RoboJackets/urc-electrical/boards/arm_board_v2.0/README.txt

Imported Library List: 

Teensy symbol and footprints library: 

symbol link:   https://github.com/XenGi/teensy_library

footprints link:   https://github.com/XenGi/teensy.pretty

TMC2209 library: 
symbol and footprints link:   https://www.snapeda.com/parts/TMC2209%20SILENTSTEPSTICK/Trinamic%20Motion%20Control%20GmbH/view-part/

J00-0045NL library: 
symbol and footprints link:   https://www.snapeda.com/parts/J00-0045NL/Pulse%20Electronics%20Network/view-part/
