RoboJackets/urc-electrical/logo/RoboBuzz wireframe.dxf

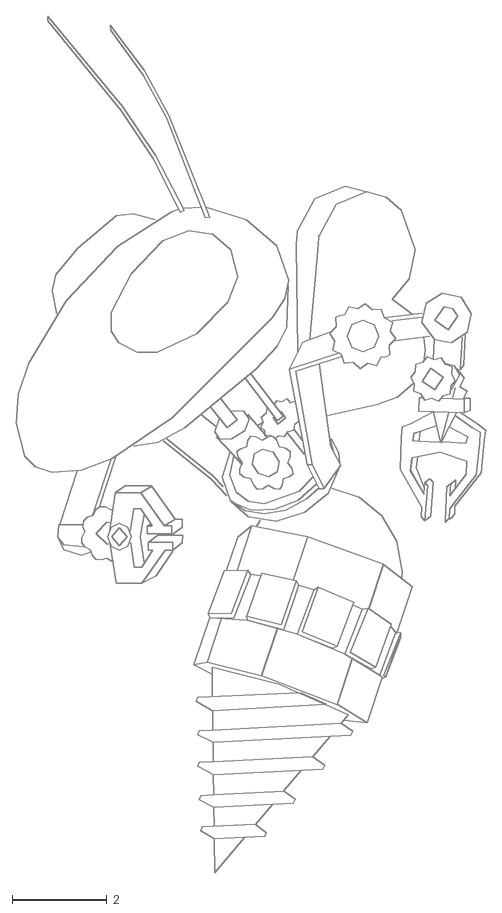
[picture p1: CAD file, 2024-04-24]
logo/RoboBuzz wireframe.dxf
9.93 x 18.1
