RoboJackets/urc-electrical/(list of files, drawings)

Other design files:
boards/arm_board_v2.0/Imported arm/arm.PcbDoc
boards/arm_board_v2.0/Imported arm/arm.PrjPcb
boards/arm_board_v2.0/Imported arm/arm.SchDoc
boards/arm_board_v2.0/Imported arm/arm.SchLib
