RoboJackets/urc-electrical/boards/Science_Board_v2.0/science-board-new.kicad_pcb

## KiCad design boards/Science_Board_v2.0/science-board-new.kicad_pcb (2025-05-12)

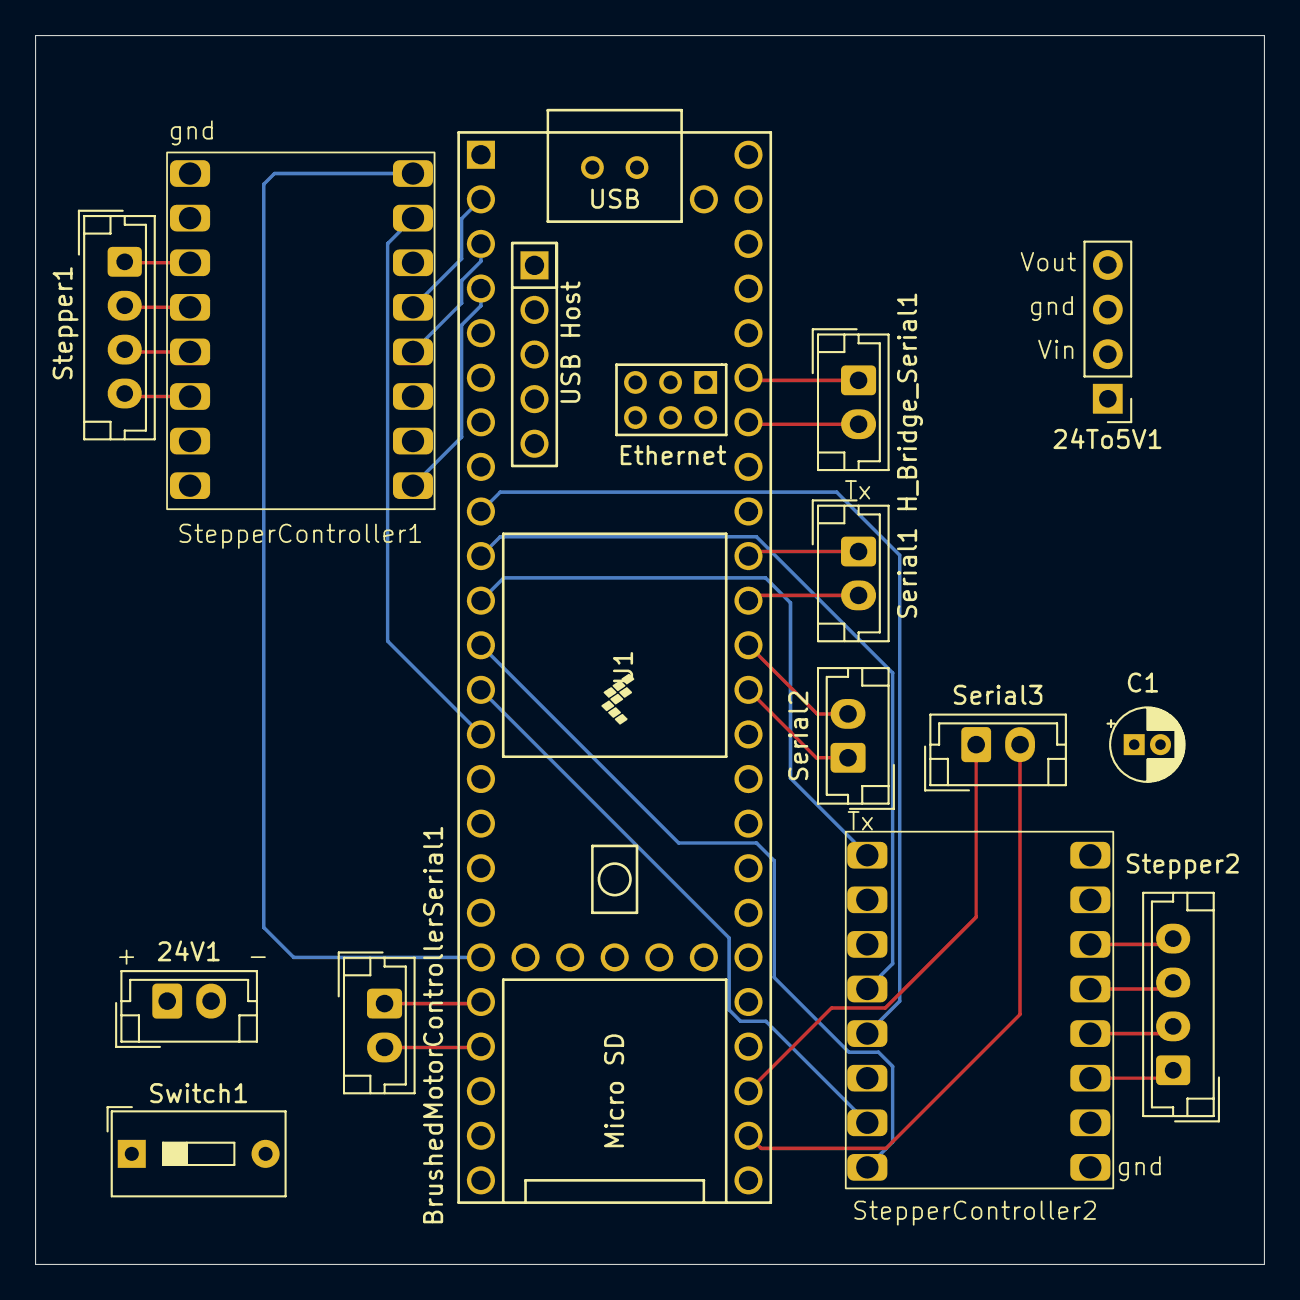
[picture p2: board science-board-new.kicad_pcb from above]

Board: 4 copper layers, 70.0 x 70.0 mm, 14 parts (0 on the bottom side), 34 nets.

Parts:
24To5V1: PinHeader_1x04_P2.54mm_Vertical
24V1: Conn_01x02; JST_EH_B2B-EH-A_1x02_P2.50mm_Vertical
BrushedMotorControllerSerial1: Conn_01x02; JST_EH_B2B-EH-A_1x02_P2.50mm_Vertical
C1: C; CP_Radial_D4.0mm_P1.50mm
H_Bridge_Serial1: Conn_01x02; JST_EH_B2B-EH-A_1x02_P2.50mm_Vertical
Serial1, Serial2, Serial3: Conn_01x02; JST_EH_B2B-EH-A_1x02_P2.50mm_Vertical
Stepper1, Stepper2: Conn_01x04; JST_EH_B4B-EH-A_1x04_P2.50mm_Vertical
StepperController1, StepperController2: Bigtree_Tech_TMC2209_V1.3
Switch1: SW_DIP_x01; SW_DIP_SPSTx01_Slide_9.78x4.72mm_W7.62mm_P2.54mm
U1: Teensy4.1; Teensy41

Connections:
/3v3_Stepper_Motor_1: StepperController1.15 (VIO), U1.46 (3V3)
/3v3_Stepper_Motor_2: StepperController2.15 (VIO), U1.15 (3V3)
/DIR_Stepper_Motor_1: StepperController1.8 (DIR), U1.19 (27_A13_SCK1)
/DIR_Stepper_Motor_2: StepperController2.8 (DIR), U1.12 (10_CS_MQSR)
/GND_Teensy: 24To5V1.3 (GND), 24V1.2, C1.2, StepperController1.10 (GND), StepperController1.16 (GND), StepperController2.10 (GND), StepperController2.16 (GND), U1.1 (GND), U1.34 (GND), U1.47 (GND)
/OUT_1: StepperController2.1 (EN), U1.11 (9_OUT1C)
/OUT_2: StepperController1.1 (EN), U1.4 (2_OUT2)
/RX_5_H_Bridge: H_Bridge_Serial1.1, U1.43 (21_A7_RX5_BCLK1)
/RX_Serial_1: Serial1.2, U1.38 (16_A2_RX4_SCL1)
/RX_Serial_2: Serial2.2, U1.37 (15_A1_RX3_SPDIF_IN)
/RX_Serial_3: Serial3.2, U1.26 (34_RX8)
/RX_Stepper_Motor_1: StepperController1.5 (TX), U1.2 (0_RX1_CRX2_CS1)
/RX_Stepper_Motor_2: StepperController2.5 (TX), U1.9 (7_RX2_OUT1A)
/RX_drill: BrushedMotorControllerSerial1.1, U1.20 (28_RX7)
/STEP_Stepper_Motor_1: StepperController1.7 (STEP), U1.14 (12_MISO_MQSL)
/STEP_Stepper_Motor_2: StepperController2.7 (STEP), U1.13 (11_MOSI_CTX1)
/TX_5_H_Bridge: H_Bridge_Serial1.2, U1.42 (20_A6_TX5_LRCLK1)
/TX_Serial_1: Serial1.1, U1.39 (17_A3_TX4_SDA1)
/TX_Serial_2: Serial2.1, U1.36 (14_A0_TX3_SPDIF_OUT)
/TX_Serial_3: Serial3.1, U1.27 (35_TX8)
/TX_Stepper_Motor_1: StepperController1.4 (RX), U1.3 (1_TX1_CTX2_MISO1)
/TX_Stepper_Motor_2: StepperController2.4 (RX), U1.10 (8_TX2_IN1)
/TX_drill: BrushedMotorControllerSerial1.2, U1.21 (29_TX7)
unnamed: 24To5V1.2 (Vin), C1.1, StepperController1.9 (VS), StepperController2.9 (VS), Switch1.2
unnamed: 24To5V1.4 (Vout), U1.48 (VIN)
unnamed: 24V1.1, Switch1.1
unnamed: Stepper1.1, StepperController1.14 (B2)
unnamed: Stepper1.2, StepperController1.13 (B1)
unnamed: Stepper1.3, StepperController1.12 (A1)
unnamed: Stepper1.4, StepperController1.11 (A2)
unnamed: Stepper2.1, StepperController2.14 (B2)
unnamed: Stepper2.2, StepperController2.13 (B1)
unnamed: Stepper2.3, StepperController2.12 (A1)
unnamed: Stepper2.4, StepperController2.11 (A2)
