RoboJackets/urc-electrical/boards/arm_board_v2.0/arm.kicad_pcb

## KiCad design boards/arm_board_v2.0/arm.kicad_pcb (2025-05-12)

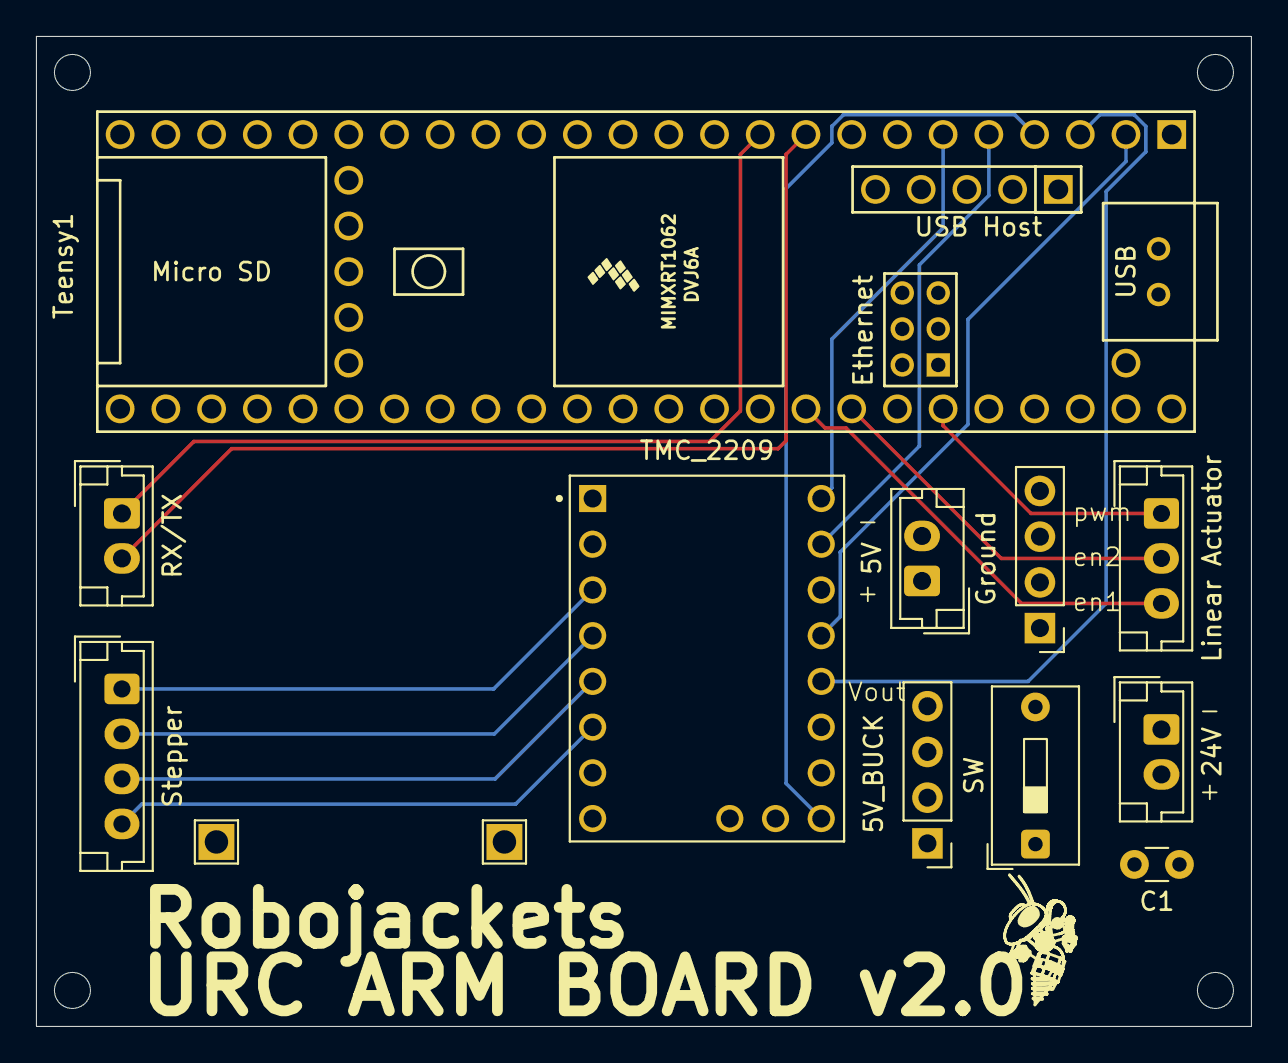
[picture p3: board boards/arm_board_v2.0/arm.kicad_pcb from above]

Board: 4 copper layers, 67.5 x 55.0 mm, 11 parts (0 on the bottom side), 19 nets.

Parts:
5V: GROUND; JST_EH_B2B-EH-A_1x02_P2.50mm_Vertical
5V_BUCK: PololuD24V5F5; PinHeader_1x04_P2.54mm_Vertical
24V: 24V; JST_EH_B2B-EH-A_1x02_P2.50mm_Vertical
C1: 33 nF; C_Disc_D3.0mm_W1.6mm_P2.50mm
Ground: Output; PinHeader_1x04_P2.54mm_Vertical
Linear Actuator: Actuator; JST_EH_B3B-EH-A_1x03_P2.50mm_Vertical
RX/TX: TX; JST_EH_B2B-EH-A_1x02_P2.50mm_Vertical
SW: SW_DIP_x01; SW_DIP_SPSTx01_Slide_9.78x4.72mm_W7.62mm_P2.54mm
Stepper: Output; JST_EH_B4B-EH-A_1x04_P2.50mm_Vertical
TMC_2209: TMC2209_SILENTSTEPSTICK; MODULE_TMC2209_SILENTSTEPSTICK
Teensy1: Teensy4.1; Teensy41

Connections:
/24V: 5V_BUCK.2 (Vin), C1.1, SW.1, TMC_2209.8 (VM)
/A1: Stepper.1, TMC_2209.3 (MA1)
/A2: Stepper.2, TMC_2209.4 (MA2)
/B1: Stepper.3, TMC_2209.5 (MB1)
/B2: Stepper.4, TMC_2209.6 (MB2)
/Switch: 24V.2, SW.2
/VIO: TMC_2209.2 (VIO), Teensy1.46 (3V3)
/Vin: 5V.1, 5V_BUCK.4 (Vout), Teensy1.48 (VIN)
GND: 5V.2, 5V_BUCK.3 (GND), 24V.1, C1.2, Ground.1, Ground.2, Ground.3, Ground.4, TMC_2209.1 (GND), TMC_2209.7 (GND), Teensy1.47 (GND)
unnamed: Linear Actuator.1, Teensy1.43 (21_A7_RX5_BCLK1)
unnamed: Linear Actuator.2, Teensy1.41 (19_A5_SCL)
unnamed: Linear Actuator.3, Teensy1.40 (18_A4_SDA)
unnamed: RX/TX.1, Teensy1.10 (8_TX2_IN1)
unnamed: RX/TX.2, Teensy1.9 (7_RX2_OUT1A)
unnamed: TMC_2209.9 (DIR), Teensy1.6 (4_BCLK2)
unnamed: TMC_2209.13 (RX), Teensy1.3 (1_TX1_CTX2_MISO1)
unnamed: TMC_2209.10 (STEP), Teensy1.5 (3_LRCLK2)
unnamed: TMC_2209.12 (TX), Teensy1.2 (0_RX1_CRX2_CS1)
unnamed: TMC_2209.16 (~EN), Teensy1.4 (2_OUT2)
