RoboJackets/urc-electrical/boards/arm_box_board/arm.kicad_pcb

## KiCad design boards/arm_box_board/arm.kicad_pcb (2025-04-29, an earlier design)

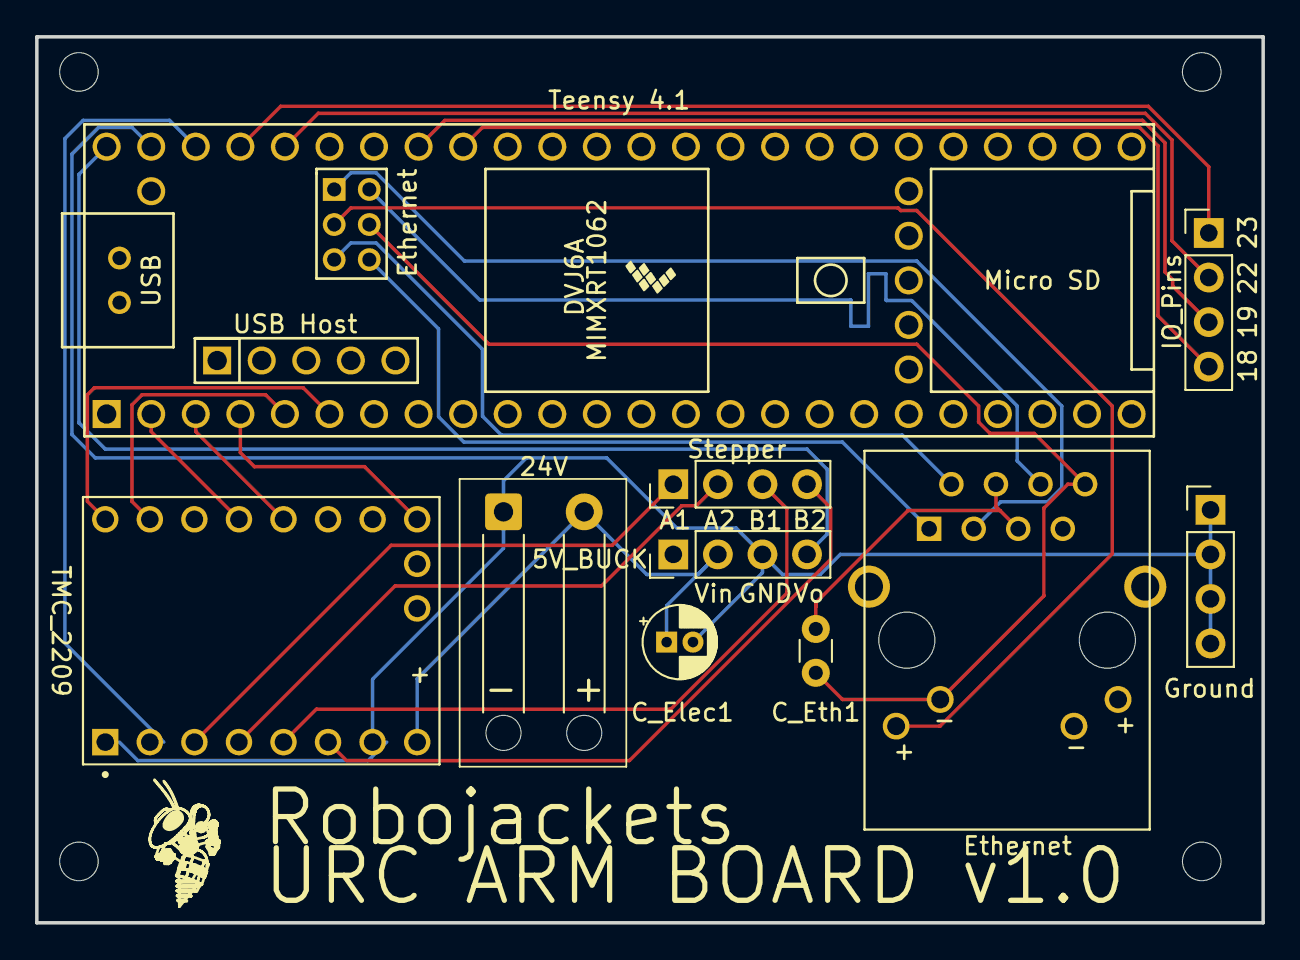
[picture p4: board boards/arm_box_board/arm.kicad_pcb from above]

Board: 2 copper layers, 69.9 x 50.5 mm, 10 parts (0 on the bottom side), 24 nets.

Parts:
5V_BUCK: PololuD24V5F5; PinHeader_1x04_P2.54mm_Vertical
24V: 24V; SolderWire-0.5sqmm_1x02_P4.6mm_D0.9mm_OD2.1mm_Relief
C_Elec1: C_Large; CP_Radial_D4.0mm_P1.50mm
C_Eth1: C_Small; C_Disc_D3.0mm_W1.6mm_P2.50mm
Ethernet: J00-0045NL; PULSE_J00-0045NL
Ground: Output; PinHeader_1x04_P2.54mm_Vertical
IO_Pins: Output; PinHeader_1x04_P2.54mm_Vertical
Stepper: Output; PinHeader_1x04_P2.54mm_Vertical
TMC_2209: TMC2209_SILENTSTEPSTICK; MODULE_TMC2209_SILENTSTEPSTICK
Teensy 4.1: Teensy4.1; Teensy41

Connections:
/A1: Stepper.1, TMC_2209.3 (MA1)
/A2: Stepper.2, TMC_2209.4 (MA2)
/B1: Stepper.3, TMC_2209.5 (MB1)
/B2: Stepper.4, TMC_2209.6 (MB2)
unnamed: 5V_BUCK.3 (GND), 24V.1, C_Elec1.2, Ground.1, Ground.2, Ground.3, Ground.4, TMC_2209.1 (GND), TMC_2209.7 (GND), Teensy 4.1.47 (GND)
unnamed: 5V_BUCK.2 (Vin), 24V.2, C_Elec1.1, TMC_2209.8 (VM)
unnamed: C_Eth1.1, Ethernet.4 (CTT), Ethernet.5 (CTR)
unnamed: C_Eth1.2, Ethernet.8 (GND), Ethernet.10 (LC), Teensy 4.1.64 (GND)
unnamed: Ethernet.9 (LA), Teensy 4.1.61 (LED)
unnamed: Ethernet.3 (RD+), Teensy 4.1.60 (R+)
unnamed: Ethernet.6 (RD-), Teensy 4.1.65 (R-)
unnamed: Ethernet.1 (TD+), Teensy 4.1.63 (T+)
unnamed: Ethernet.2 (TD-), Teensy 4.1.62 (T-)
unnamed: IO_Pins.1, Teensy 4.1.45 (23_A9_CRX1_MCLK1)
unnamed: IO_Pins.2, Teensy 4.1.44 (22_A8_CTX1)
unnamed: IO_Pins.3, Teensy 4.1.41 (19_A5_SCL)
unnamed: IO_Pins.4, Teensy 4.1.40 (18_A4_SDA)
unnamed: 5V_BUCK.4 (Vout), Teensy 4.1.48 (VIN)
unnamed: TMC_2209.9 (DIR), Teensy 4.1.6 (4_BCLK2)
unnamed: TMC_2209.13 (RX), Teensy 4.1.3 (1_TX1_CTX2_MISO1)
unnamed: TMC_2209.10 (STEP), Teensy 4.1.5 (3_LRCLK2)
unnamed: TMC_2209.12 (TX), Teensy 4.1.2 (0_RX1_CRX2_CS1)
unnamed: TMC_2209.2 (VIO), Teensy 4.1.46 (3V3)
unnamed: TMC_2209.16 (~EN), Teensy 4.1.4 (2_OUT2)
