RoboJackets/urc-electrical/boards/Main/Main/Main.kicad_pcb

## KiCad design boards/Main/Main/Main.kicad_pcb (2025-03-07)

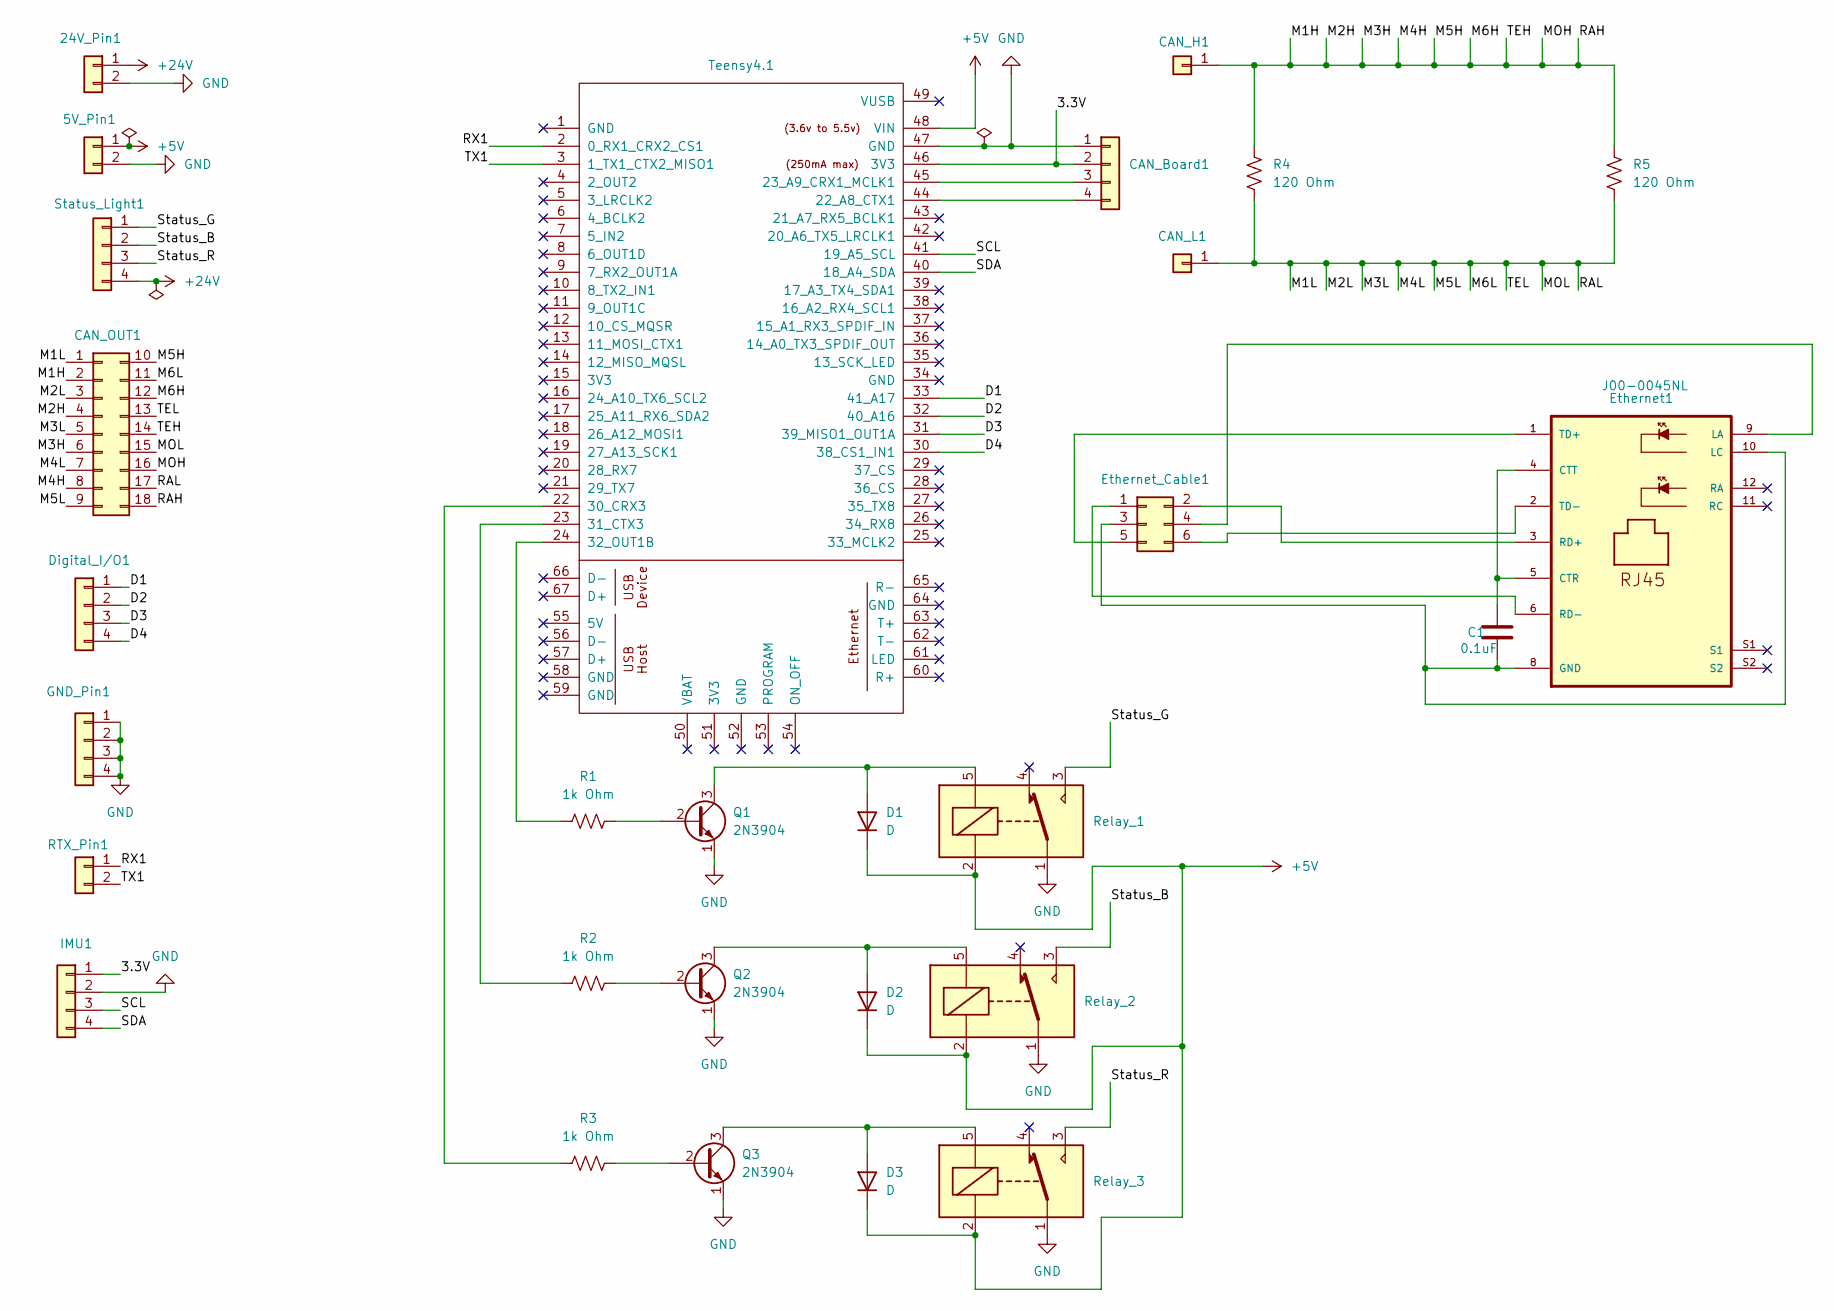
[picture p5: schematic Main.kicad_sch, Electrical Main Board]

Parts:
5V_Pin1: 5V; PinHeader_1x02_P2.54mm_Vertical
24V_Pin1: 24V; PinHeader_1x02_P2.54mm_Vertical
C1: 0.1uF; CP_Axial_L10.0mm_D4.5mm_P15.00mm_Horizontal
CAN_Board1: CAN_Board; PinHeader_1x04_P2.54mm_Vertical
CAN_H1: CAN_H; PinHeader_1x01_P2.54mm_Vertical
CAN_L1: CAN_L; PinHeader_1x01_P2.54mm_Vertical
CAN_OUT1: CAN_pins; PinHeader_2x09_P2.54mm_Vertical
D1, D2, D3: D; LED_D5.0mm
Digital_I/O1: Digital I/O; PinHeader_1x04_P2.54mm_Vertical
Ethernet1: J00-0045NL; PULSE_J00-0045NL
Ethernet_Cable1: Conn_02x03_Odd_Even; PinHeader_2x03_P2.54mm_Vertical
GND_Pin1: GND; PinHeader_1x04_P2.54mm_Vertical
IMU1: GND; PinHeader_1x04_P2.54mm_Vertical
Q1, Q2, Q3: 2N3904; TO-92_Inline
R1, R2, R3: 1k Ohm; R_Axial_DIN0309_L9.0mm_D3.2mm_P15.24mm_Horizontal
R4, R5: 120 Ohm; R_Axial_DIN0309_L9.0mm_D3.2mm_P15.24mm_Horizontal
RTX_Pin1: TX/RX; PinHeader_1x02_P2.54mm_Vertical
Relay_1: G5LE1_Green; Relay_SPDT_Omron-G5LE-1
Relay_2: G5LE1_Blue; Relay_SPDT_Omron-G5LE-1
Relay_3: G5LE1_Red; Relay_SPDT_Omron-G5LE-1
Status_Light1: Status_Light; PinHeader_1x04_P2.54mm_Vertical
Teensy4.1: Teensy4.1; Teensy41

Connections:
+5V: 5V_Pin1.1, D1.1 (K), D2.1 (K), D3.1 (K), Relay_1.2, Relay_2.2, Relay_3.2, Teensy4.1.48 (VIN)
+24V: 24V_Pin1.1, Status_Light1.4
/3.3V: CAN_Board1.2, IMU1.1, Teensy4.1.46 (3V3)
/D1: Digital_I/O1.1, Teensy4.1.33 (41_A17)
/D2: Digital_I/O1.2, Teensy4.1.32 (40_A16)
/D3: Digital_I/O1.3, Teensy4.1.31 (39_MISO1_OUT1A)
/D4: Digital_I/O1.4, Teensy4.1.30 (38_CS1_IN1)
/M1H: CAN_H1.1, CAN_OUT1.2, CAN_OUT1.4, CAN_OUT1.6, CAN_OUT1.8, CAN_OUT1.10, CAN_OUT1.12, CAN_OUT1.14, CAN_OUT1.16, CAN_OUT1.18, R4.1, R5.2
/M1L: CAN_L1.1, CAN_OUT1.1, CAN_OUT1.3, CAN_OUT1.5, CAN_OUT1.7, CAN_OUT1.9, CAN_OUT1.11, CAN_OUT1.13, CAN_OUT1.15, CAN_OUT1.17, R4.2, R5.1
/RX1: RTX_Pin1.1, Teensy4.1.2 (0_RX1_CRX2_CS1)
/SCL: IMU1.3, Teensy4.1.41 (19_A5_SCL)
/SDA: IMU1.4, Teensy4.1.40 (18_A4_SDA)
/Status_B: Relay_2.3, Status_Light1.2
/Status_G: Relay_1.3, Status_Light1.1
/Status_R: Relay_3.3, Status_Light1.3
/TX1: RTX_Pin1.2, Teensy4.1.3 (1_TX1_CTX2_MISO1)
GND: 5V_Pin1.2, 24V_Pin1.2, CAN_Board1.1, GND_Pin1.1, GND_Pin1.2, GND_Pin1.3, GND_Pin1.4, IMU1.2, Q1.1 (E), Q2.1 (E), Q3.1 (E), Relay_1.1, Relay_2.1, Relay_3.1, Teensy4.1.47 (GND)
unnamed: CAN_Board1.3, Teensy4.1.45 (23_A9_CRX1_MCLK1)
unnamed: CAN_Board1.4, Teensy4.1.44 (22_A8_CTX1)
unnamed: D1.2 (A), Q1.3 (C), Relay_1.5
unnamed: D2.2 (A), Q2.3 (C), Relay_2.5
unnamed: D3.2 (A), Q3.3 (C), Relay_3.5
unnamed: C1.1, Ethernet1.4 (CTT), Ethernet1.5 (CTR)
unnamed: C1.2, Ethernet1.8 (GND), Ethernet1.10 (LC), Ethernet_Cable1.3
unnamed: Ethernet1.9 (LA), Ethernet_Cable1.4
unnamed: Ethernet1.3 (RD+), Ethernet_Cable1.2
unnamed: Ethernet1.6 (RD-), Ethernet_Cable1.1
unnamed: Ethernet1.1 (TD+), Ethernet_Cable1.5
unnamed: Ethernet1.2 (TD-), Ethernet_Cable1.6
unnamed: Q1.2 (B), R1.2
unnamed: Q2.2 (B), R2.2
unnamed: Q3.2 (B), R3.2
unnamed: R3.1, Teensy4.1.22 (30_CRX3)
unnamed: R2.1, Teensy4.1.23 (31_CTX3)
unnamed: R1.1, Teensy4.1.24 (32_OUT1B)

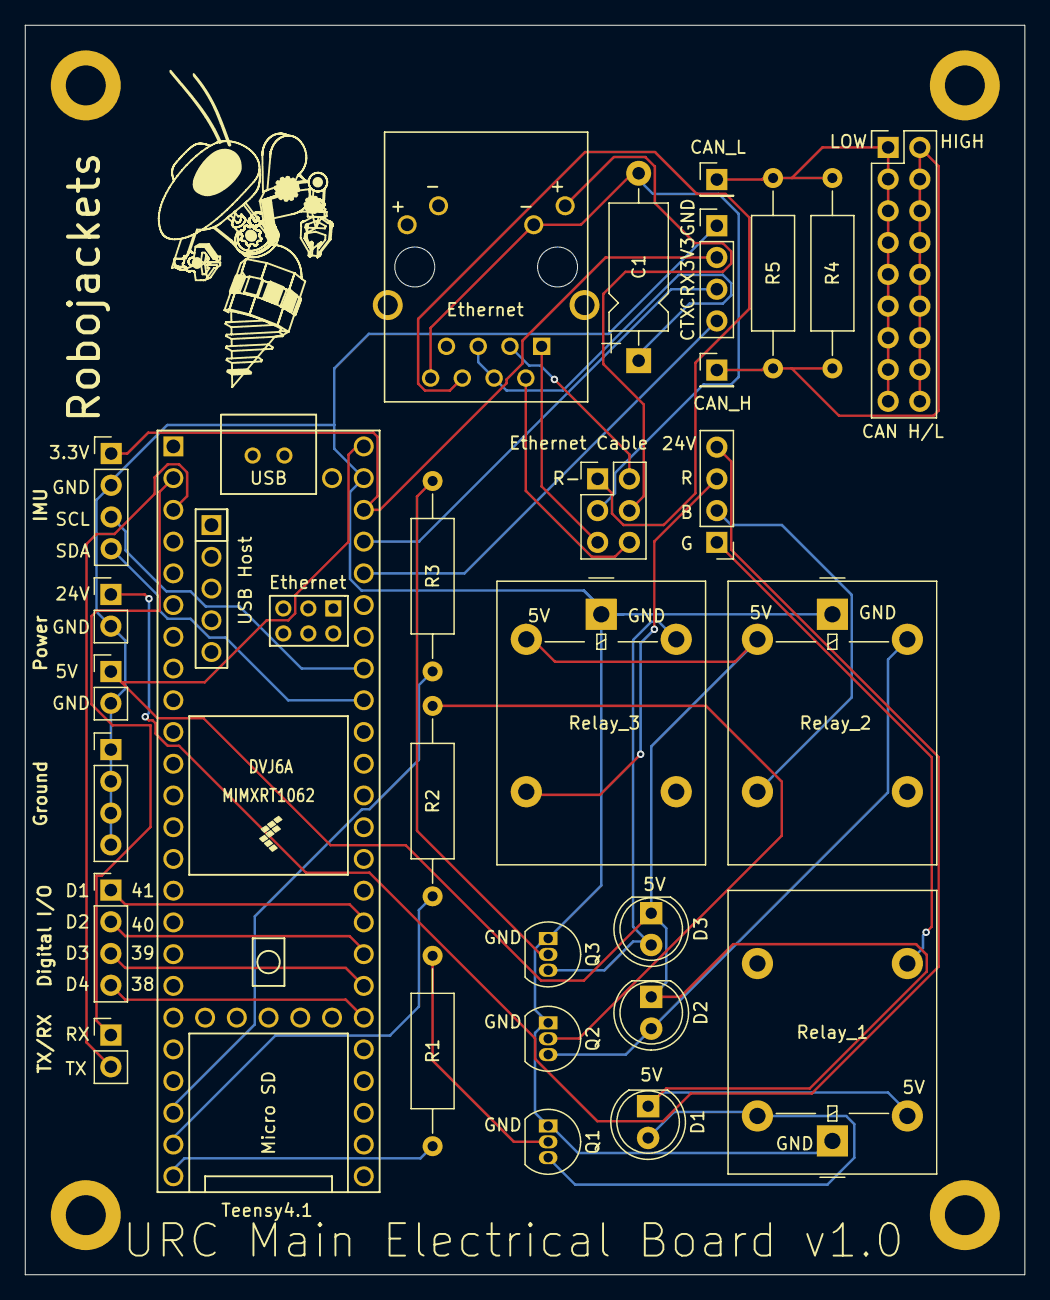
[picture p6: board Main.kicad_pcb from above]

Board: 2 copper layers, 80.0 x 100.0 mm, 30 parts (0 on the bottom side), 35 nets.

Other parts of the board:
GND: MountingHole_3.2mm_M3_DIN965_Pad
