RoboJackets/urc-electrical/boards/Solo_Uno_side_panel/solouno_sidepanel/solouno_sidepanel.kicad_pcb

## KiCad design boards/Solo_Uno_side_panel/solouno_sidepanel/solouno_sidepanel.kicad_pcb (2024-12-05)

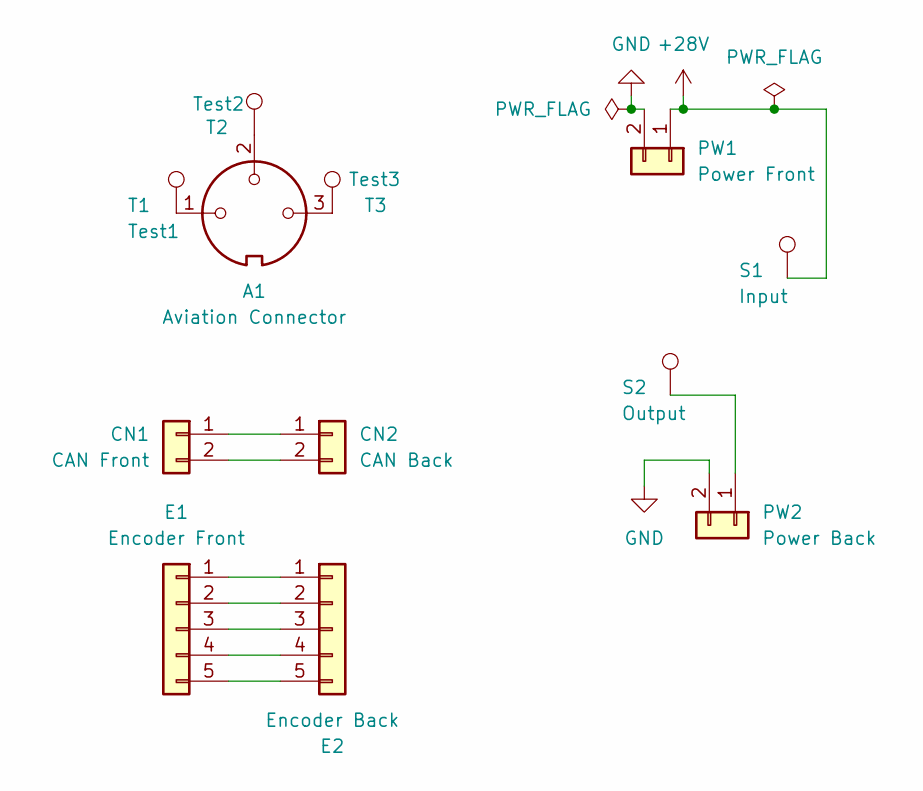
[picture p7: schematic solouno_sidepanel.kicad_sch]

Parts:
A1: Aviation Connector; GX-16-3
CN1: CAN Front; JST_EH_B2B-EH-A_1x02_P2.50mm_Vertical
CN2: CAN Back; JST_EH_B2B-EH-A_1x02_P2.50mm_Vertical
E1: Encoder Front; JST_EH_B5B-EH-A_1x05_P2.50mm_Vertical
E2: Encoder Back; JST_EH_B5B-EH-A_1x05_P2.50mm_Vertical
PW1: Power Front; JST_EH_B2B-EH-A_1x02_P2.50mm_Vertical
PW2: Power Back; JST_EH_B2B-EH-A_1x02_P2.50mm_Vertical
S1: Input; TestPoint_Loop_D3.50mm_Drill1.4mm_Beaded
S2: Output; TestPoint_Loop_D3.50mm_Drill1.4mm_Beaded
T1: Test1; TestPoint_Pad_1.5x1.5mm
T2: Test2; TestPoint_Pad_1.5x1.5mm
T3: Test3; TestPoint_Pad_1.5x1.5mm

Connections:
+28V: PW1.1, S1.1
GND: PW1.2, PW2.2
unnamed: A1.1, T1.1
unnamed: A1.2, T2.1
unnamed: A1.3, T3.1
unnamed: CN1.1, CN2.1
unnamed: CN1.2, CN2.2
unnamed: E1.1, E2.1
unnamed: E1.2, E2.2
unnamed: E1.3, E2.3
unnamed: E1.4, E2.4
unnamed: E1.5, E2.5
unnamed: PW2.1, S2.1

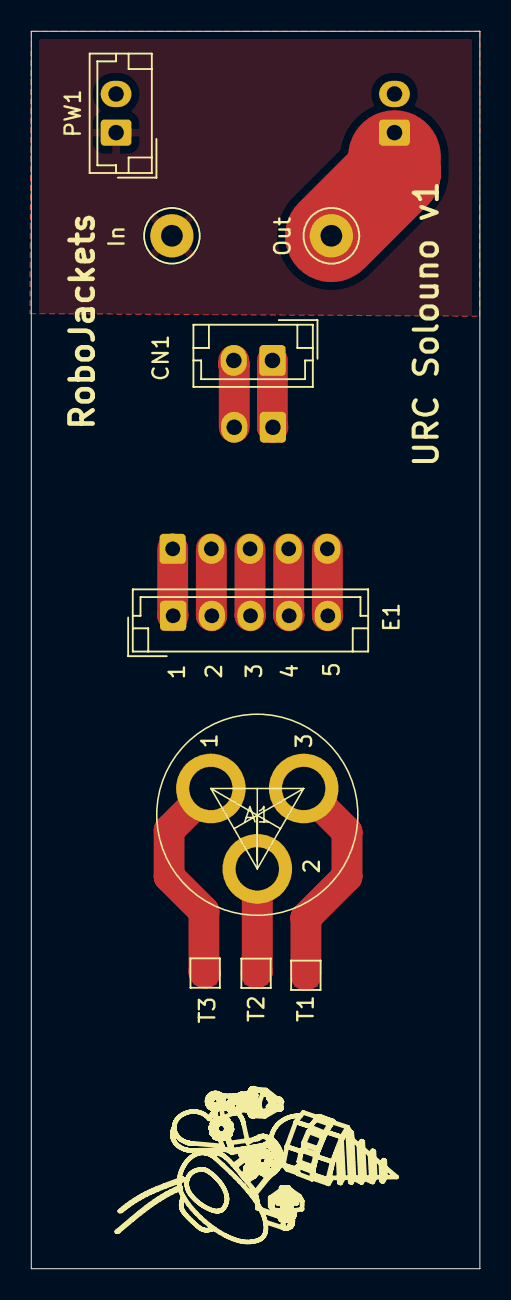
[picture p8: board solouno_sidepanel.kicad_pcb from above]

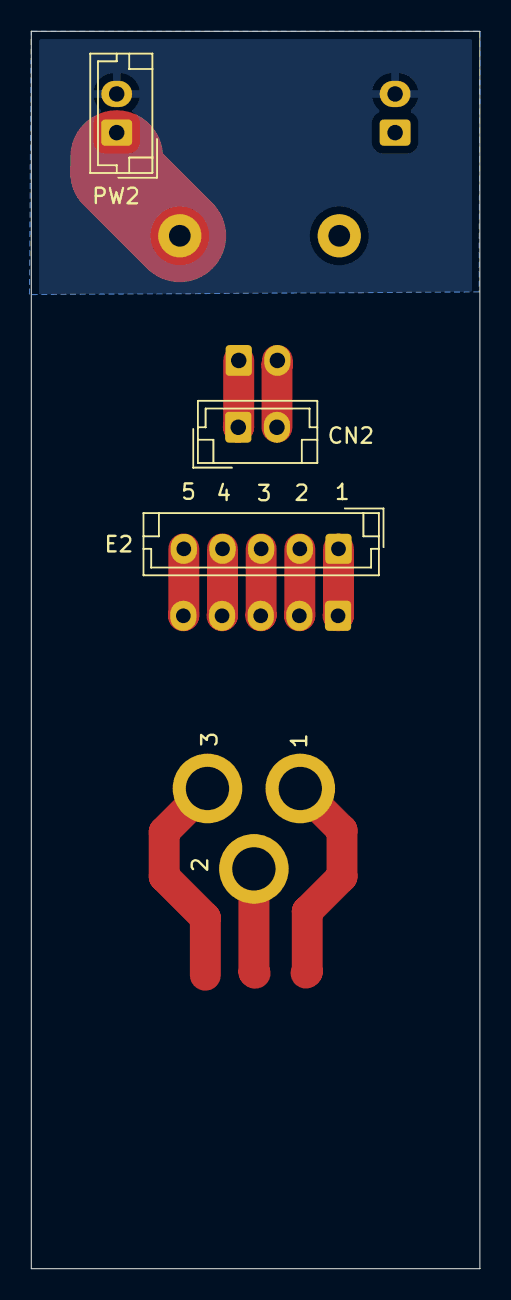
[picture p9: board solouno_sidepanel.kicad_pcb from below]

Board: 2 copper layers, 29.0 x 80.0 mm, 12 parts (3 on the bottom side), 13 nets.
