RoboJackets/urc-electrical/boards/science-board/science-board.kicad_pcb

## KiCad design boards/science-board/science-board.kicad_pcb (2024-08-28)

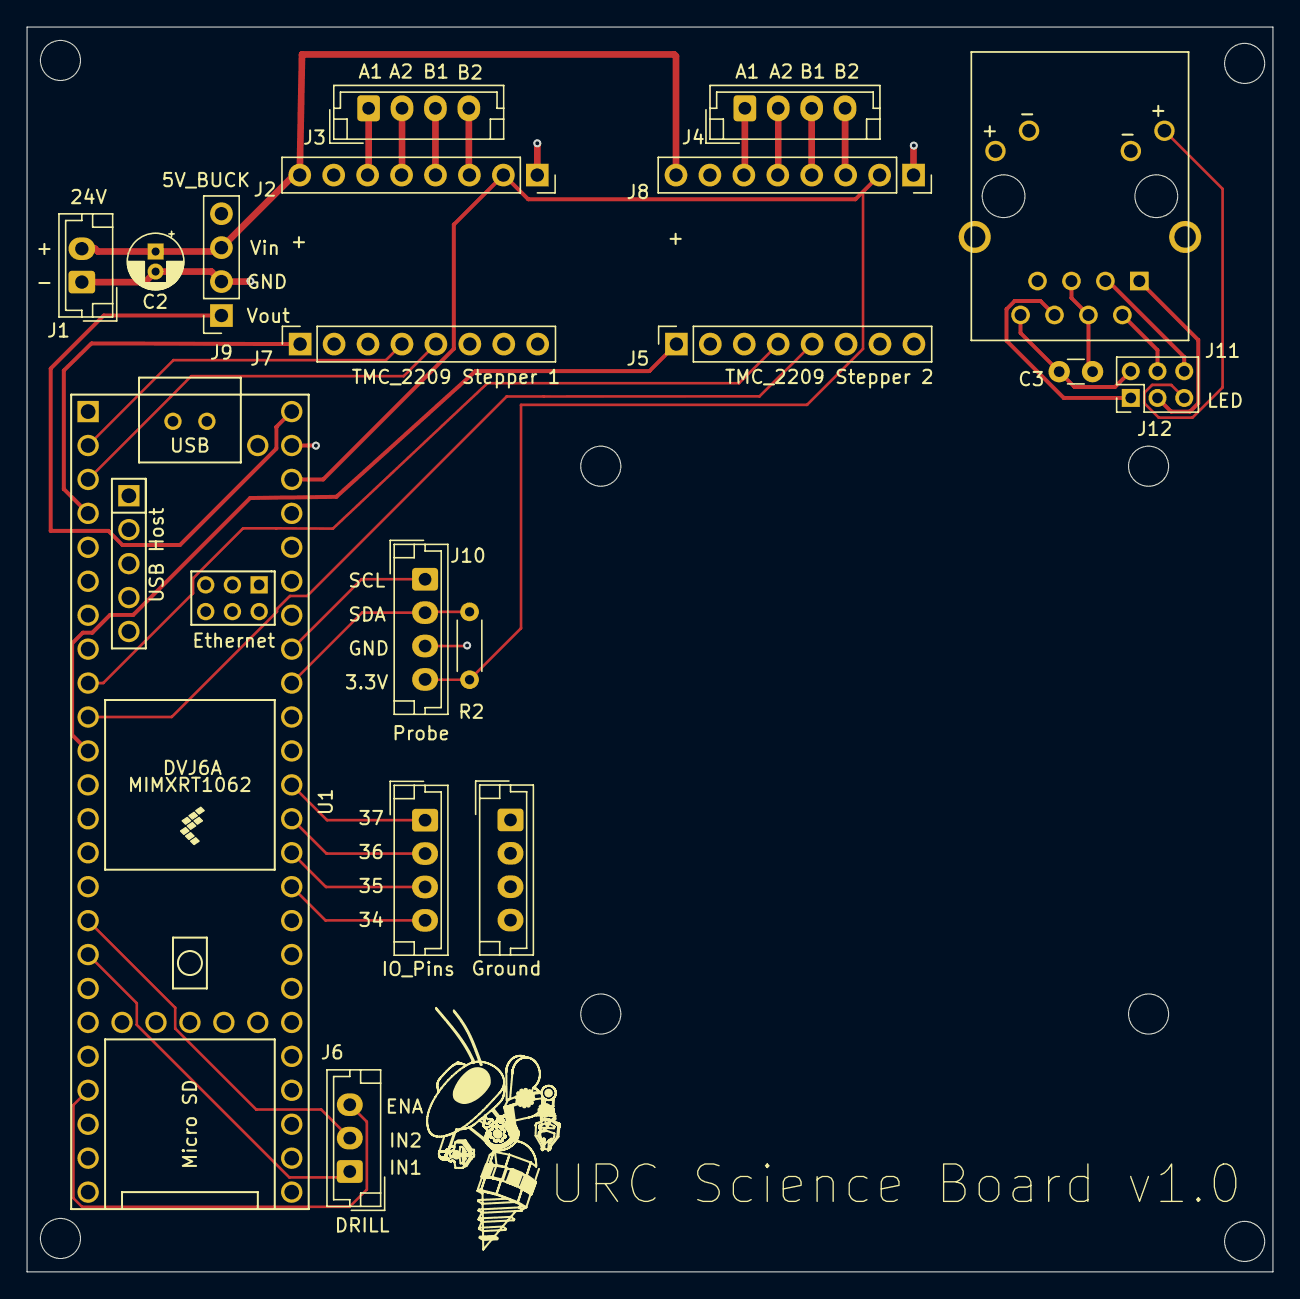
[picture p10: board science-board.kicad_pcb from above]

Board: 2 copper layers, 93.2 x 93.2 mm, 18 parts (0 on the bottom side), 33 nets.

Parts:
C2: 33uF; CP_Radial_D4.0mm_P1.50mm
C3: 0.1uF; C_Disc_D3.0mm_W1.6mm_P2.50mm
Ground: Conn_01x04; JST_EH_B4B-EH-A_1x04_P2.50mm_Vertical
IO_Pins: Conn_01x04; JST_EH_B4B-EH-A_1x04_P2.50mm_Vertical
J1: Conn_01x02; JST_EH_B2B-EH-A_1x02_P2.50mm_Vertical
J2, J5, J7, J8: Conn_01x08; PinSocket_1x08_P2.54mm_Vertical
J3, J4, J10: Conn_01x04; JST_EH_B4B-EH-A_1x04_P2.50mm_Vertical
J6: Conn_01x03; JST_EH_B3B-EH-A_1x03_P2.50mm_Vertical
J9: Conn_01x04; PinSocket_1x04_P2.54mm_Vertical
J11: J00-0045NL; PULSE_J00-0045NL
J12: Conn_02x03_Counter_Clockwise; PinHeader_2x03_P2.00mm_Vertical
R2: 10k; R_Axial_DIN0204_L3.6mm_D1.6mm_P5.08mm_Horizontal
U1: Teensy4.1; Teensy41

Connections:
+3.3V: J2.2, J8.2, J10.4, R2.2, U1.46 (3V3)
+5V: J9.1, U1.48 (VIN)
+24V: C2.1, J1.2, J2.8, J8.8, J9.3
/34: IO_Pins.4, U1.34 (GND)
/35: IO_Pins.3, U1.35 (13_SCK_LED)
/36: IO_Pins.2, U1.36 (14_A0_TX3_SPDIF_OUT)
/37: IO_Pins.1, U1.37 (15_A1_RX3_SPDIF_IN)
/CTR: C3.1, J11.4 (CTT), J11.5 (CTR)
/D1_A1: J2.5, J3.2
/D1_A2: J2.6, J3.1
/D1_B1: J2.4, J3.3
/D1_B2: J2.3, J3.4
/D1_EN: J7.1, U1.4 (2_OUT2)
/D1_RX: J7.5, U1.3 (1_TX1_CTX2_MISO1)
/D1_TX: J7.4, U1.2 (0_RX1_CRX2_CS1)
/D2_A1: J4.2, J8.5
/D2_A2: J4.1, J8.6
/D2_B1: J4.3, J8.4
/D2_B2: J4.4, J8.3
/D2_EN: J5.1, U1.11 (9_OUT1C)
/D2_RX: J5.5, U1.10 (8_TX2_IN1)
/D2_TX: J5.4, U1.9 (7_RX2_OUT1A)
/EN1: J6.1, U1.17 (25_A11_RX6_SDA2)
/EN2: J6.2, U1.16 (24_A10_TX6_SCL2)
/ENA: J6.3, U1.21 (29_TX7)
/LED: J11.9 (LA), J12.5
/RX+: J11.3 (RD+), J12.6
/RX-: J11.6 (RD-), J12.1
/TX+: J11.1 (TD+), J12.3
/TX-: J11.2 (TD-), J12.4
GND: C2.2, C3.2, Ground.1, Ground.2, Ground.3, Ground.4, J1.1, J2.1, J2.7, J8.1, J8.7, J9.2, J10.3, J11.8 (GND), J11.10 (LC), J12.2, U1.47 (GND)
SCL: J10.1, U1.41 (19_A5_SCL)
SDA: J10.2, R2.1, U1.40 (18_A4_SDA)
