RoboJackets/urc-electrical/boards/status_light/status_light.kicad_pcb

## KiCad design boards/status_light/status_light.kicad_pcb (2024-04-11)

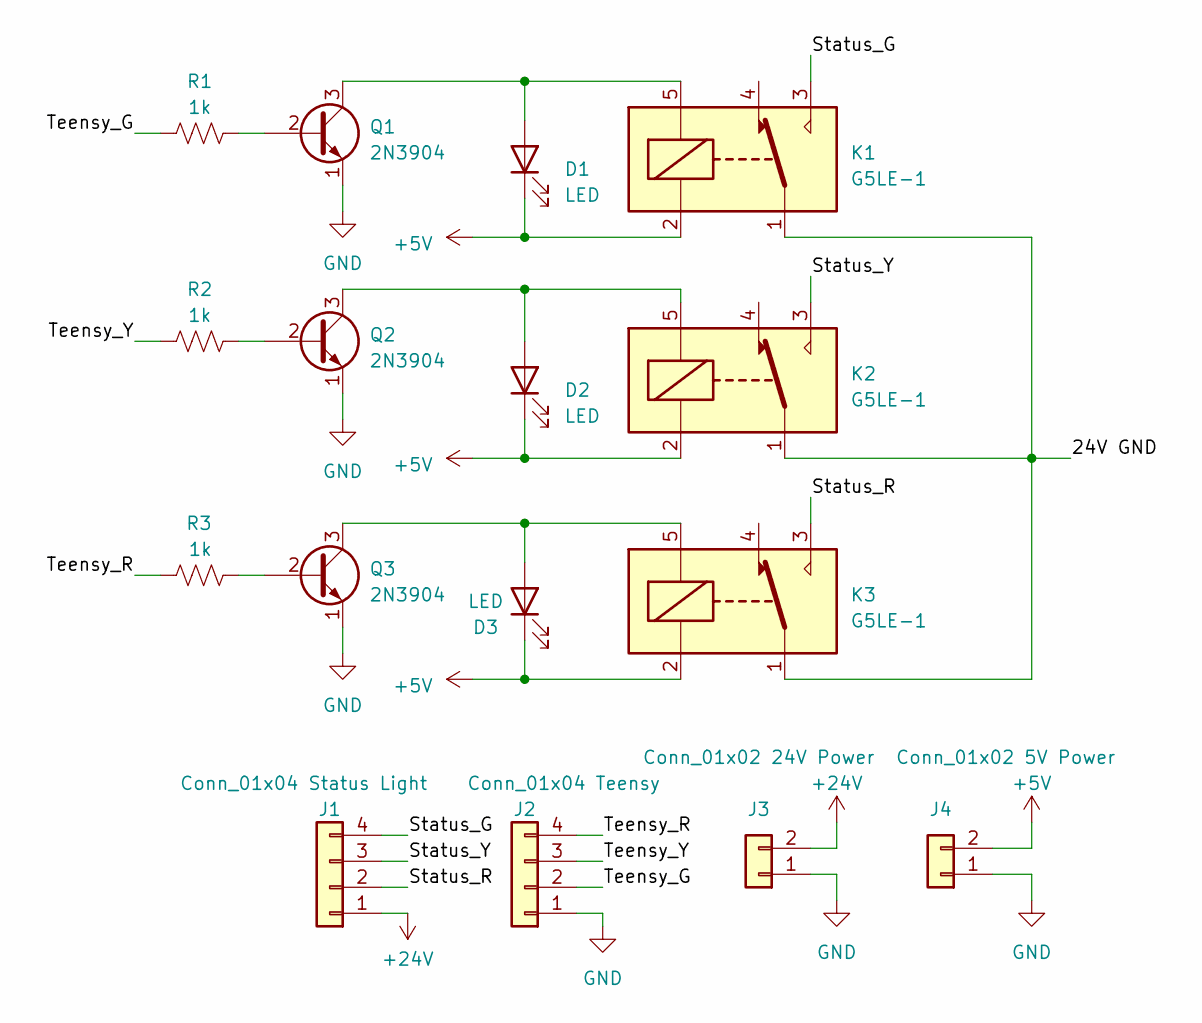
[picture p11: schematic status_light.kicad_sch]

Parts:
D1, D2, D3: LED; LED_D5.0mm-3
J1: Conn_01x04 Status Light; PinHeader_1x04_P2.54mm_Vertical
J2: Conn_01x04 Teensy; PinHeader_1x04_P2.54mm_Vertical
J3: Conn_01x02 24V Power; PinHeader_1x02_P2.54mm_Vertical
J4: Conn_01x02 5V Power; PinHeader_1x02_P2.54mm_Vertical
K1, K2, K3: G5LE-1; Relay_SPDT_Omron-G5LE-1
Q1, Q2, Q3: 2N3904; TO-92_Inline
R1, R2, R3: 1k; R_Axial_DIN0309_L9.0mm_D3.2mm_P15.24mm_Horizontal

Connections:
+5V: D1.1 (K), D2.1 (K), D3.1 (K), J4.2, K1.2, K2.2, K3.2
+24V: J1.1, J3.2
/24V GND: K1.1, K2.1, K3.1
/Status_G: J1.4, K1.3
/Status_R: J1.2, K3.3
/Status_Y: J1.3, K2.3
/Teensy_G: J2.2, R1.1
/Teensy_R: J2.4, R3.1
/Teensy_Y: J2.3, R2.1
GND: J2.1, J3.1, J4.1, Q1.1 (E), Q2.1 (E), Q3.1 (E)
unnamed: D1.2 (A), K1.5, Q1.3 (C)
unnamed: D2.2 (A), K2.5, Q2.3 (C)
unnamed: D3.2 (A), K3.5, Q3.3 (C)
unnamed: Q1.2 (B), R1.2
unnamed: Q2.2 (B), R2.2
unnamed: Q3.2 (B), R3.2

Board: 2 copper layers, 16 parts (0 on the bottom side), 16 nets, no tracks yet.
