RoboJackets/urc-electrical/(commit log)

2024-03-07 Added BMS balance leads.
    [bms-balance-leads.kicad_pcb, bms-balance-leads.kicad_sch]
2024-04-11 Added Status Light Board
    To be merged into Main Board eventually
    [bms-balance-leads.kicad_pcb, bms-balance-leads.kicad_sch, status_light.kicad_pcb, status_light.kicad_sch]
2024-04-13 Preliminary progress on science board.
    [science-board.kicad_pcb, science-board.kicad_sch]
2024-04-14 Finished preliminary routing. Used through-hole footprints.
    [science-board.kicad_pcb, science-board.kicad_sch]
2024-04-14 Updated board measurements.
    [science-board.kicad_pcb]
2024-04-17 Updated main schematic
    [Main.kicad_pcb, Main.kicad_sch]
2024-04-22 Updated Main PCB
    [Main.kicad_pcb, Main.kicad_sch]
2024-04-24 Added Ethernet module.
    [science-board.kicad_pcb, science-board.kicad_sch]
2024-04-24 Updated Arm board with ethernet
    updated on 04/24
    [arm.kicad_pcb, arm.kicad_sch]
2024-04-24 Added Logo
    [RoboBuzz wireframe.dxf]
2024-04-24 Switched RX/TX pin position and IMU pin position
    [Main.kicad_pcb]
2024-04-25 moved science board to boards
    [science-board.kicad_pcb, science-board.kicad_sch]
2024-04-25 cap added
    [arm.kicad_pcb]
2024-04-25 Added logo to science board
    [science-board.kicad_pcb]
2024-04-26 Added Holes to Main PCB
    [Main.kicad_pcb, Main.kicad_sch]
2024-04-28 Corrected Ethernet pin matches to teensy
    [arm.kicad_pcb, arm.kicad_sch]
2024-04-28 updated GND plane and unconnected pins
    [science-board.kicad_pcb, science-board.kicad_sch]
2024-04-28 updated science board-GND
    [science-board.kicad_pcb, science-board.kicad_sch]
2024-04-28 updated main board
    [Main.kicad_pcb, Main.kicad_sch]
2024-04-28 labelled digital input pins
    [Main.kicad_pcb]
2024-04-28 Extra pins/labels added
    [arm.kicad_pcb, arm.kicad_sch]
2024-04-28 last update
    [arm.kicad_pcb]
2024-05-02 Changes to Science and Arm Board
    Added pin labels to both boards
    Fixed Mislabeled Stepper Board Footprint in Arm board
    Added extra digital pins and ground in Science Board
    [arm.kicad_pcb, arm.kicad_sch, science-board.kicad_pcb, science-board.kicad_sch]
2024-05-04 Removed I2C level converter from Science Board
    BRUH
    The temperature probe works running on 3.3V so the level converter for I2C wasn't even necessary on the Science Board. I have removed it from the schematic and updated the PCB layout.
    [science-board.kicad_pcb, science-board.kicad_sch]
2024-05-05 Prepared Boards for PCB Manufacture
    Added GND line for IMU on Main Board
    Fixed Silkscreen Text Size for PCB Manufacture on Science, Main, and Arm boards
    Generated Gerber Files for Science, Main, and Arm boards
    [Main-B_Cu.gbl, Main-B_Mask.gbs, Main-B_Paste.gbp, Main-B_Silkscreen.gbo, Main-Edge_Cuts.gm1, Main-F_Cu.gtl, Main-F_Mask.gts, Main-F_Paste.gtp]
2024-05-10 Changed Resistor Value for status light circuit in Main Board
    Updated value to 1k from 100 Ohms
2024-08-28 Solo Uno Module Side Panel PCB
    started
    [solouno_sidepanel.kicad_pcb, solouno_sidepanel.kicad_sch]
2024-09-15 Made Symbols and Footprint Library for RoboNav
2024-09-22 Add files via upload
    Updated Solo uno board
    [solouno_sidepanel.kicad_pcb, solouno_sidepanel.kicad_sch]
2024-10-14 Started 4 layer PCB
    [Main.kicad_sch, Main_4layer.kicad_pcb, Main_4layer.kicad_sch]
2024-11-03 4 layer main
    [Main_4layer.kicad_pcb, Main_4layer.kicad_sch]
2024-11-03 updated 4-layer
    [Main_4layer.kicad_pcb, Main_4layer.kicad_sch]
2024-11-03 4layer update
    [Main_4layer.kicad_pcb]
2024-11-04 Updated Solon
    [solouno_sidepanel.kicad_pcb, solouno_sidepanel.kicad_sch]
2024-11-11 Main 4layer with Gerber
    [Main_4layer.kicad_pcb, Main_4layer.kicad_sch]
2024-11-11 side panel with Gerber
    waiting for final aviation dimensions
    [solouno_sidepanel.kicad_pcb, solouno_sidepanel.kicad_sch]
2024-11-14 side panel
    [solouno_sidepanel.kicad_pcb, solouno_sidepanel.kicad_sch]
2024-11-14 Edited the GX-16-3 Footprint with correct dimensions
2024-11-17 updated solouno with new footprint
    [Untitled.kicad_pcb, Untitled.kicad_sch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]
2024-11-18 Editing 4layer_main for Fabrication
    Made trace width 0.25mm
    Fixed power planes for 5v, 3.3v, and 24v
    Flipped around CAN transceiver pins
    Added RoboJackets font to board title
    [Main_4layer-B_Cu.gbl, Main_4layer-B_Mask.gbs, Main_4layer-B_Paste.gbp, Main_4layer-B_Silkscreen.gbo, Main_4layer-Edge_Cuts.gm1, Main_4layer-F_Cu.gtl, Main_4layer-F_Mask.gts, Main_4layer-F_Paste.gtp]
2024-11-21 updated Solouno
    Two pin for rocker switch
    [Main_4layer-B_Cu.gbl, Main_4layer-B_Mask.gbs, Main_4layer-B_Paste.gbp, Main_4layer-B_Silkscreen.gbo, Main_4layer-Edge_Cuts.gm1, Main_4layer-F_Cu.gtl, Main_4layer-F_Mask.gts, Main_4layer-F_Paste.gtp]
2024-11-21 solouno update
    [solouno_sidepanel-B_Cu.gbr, solouno_sidepanel-B_Mask.gbr, solouno_sidepanel-B_Paste.gbr, solouno_sidepanel-B_Silkscreen.gbr, solouno_sidepanel-Edge_Cuts.gbr, solouno_sidepanel-F_Cu.gbr, solouno_sidepanel-F_Mask.gbr, solouno_sidepanel-F_Paste.gbr]
2024-12-05 Fixed MotorController Board PCB and Footprint for Aviation Connector
    [solouno_sidepanel-B_Cu.gbr, solouno_sidepanel-B_Mask.gbr, solouno_sidepanel-B_Paste.gbr, solouno_sidepanel-B_Silkscreen.gbr, solouno_sidepanel-Edge_Cuts.gbr, solouno_sidepanel-F_Cu.gbr, solouno_sidepanel-F_Mask.gbr, solouno_sidepanel-F_Paste.gbr]
2025-03-07 Libraries added
    [Main.kicad_pcb, Main_4layer.kicad_pcb, Main_4layer.kicad_sch, arm.PcbDoc, arm.PrjPcb, arm.SchDoc, arm.SchLib]
2025-03-07 Closed the KiCAD window
    [Main_4layer.kicad_pcb, Main_4layer.kicad_sch]
2025-03-09 Restore stashed changes
    [Main_4layer.kicad_sch]
2025-03-09 Revert changes
    [Main.kicad_pcb, Main_4layer.kicad_pcb, Main_4layer.kicad_sch, arm.PcbDoc, arm.PrjPcb, arm.SchDoc, arm.SchLib]
2025-03-09 Libraries readded
    [Main.kicad_pcb, Main_4layer.kicad_pcb, Main_4layer.kicad_sch, arm.PcbDoc, arm.PrjPcb, arm.SchDoc, arm.SchLib]
2025-04-18 Add files via upload
    Added schematics for new science PCB
    [science-board-new.kicad_pcb, science-board-new.kicad_sch]
2025-04-18 Create Science_Board_New
    Added Folder for New Science Board
2025-04-18 Created Folder for New Science Board
2025-04-18 Added New Science Board Schematics
    [science-board-new.kicad_pcb, science-board-new.kicad_sch]
2025-04-25 Create folder for New Science Board Gerber
2025-04-25 Added Gerber files for New Science Board
    [science-board-new-NPTH.drl, science-board-new-PTH.drl]
2025-04-29 Added New Arm PCB
    [arm-B_Cu.gbl, arm-B_Mask.gbs, arm-B_Paste.gbp, arm-B_Silkscreen.gbo, arm-Edge_Cuts.gm1, arm-F_Cu.gtl, arm-F_Mask.gts, arm-F_Paste.gtp]
2025-05-01 Added Gerber Files for arm board
    [arm-B_Cu.gbr, arm-B_Mask.gbr, arm-B_Paste.gbr, arm-B_Silkscreen.gbr, arm-Edge_Cuts.gbr, arm-F_Cu.gbr, arm-F_Mask.gbr, arm-F_Paste.gbr]
2025-05-12 Arm_v2.0 & Science_v2.0 final version
    [arm-B_Cu.gbl, arm-B_Cu.gbr, arm-B_Mask.gbr, arm-B_Mask.gbs, arm-B_Paste.gbp, arm-B_Paste.gbr, arm-B_Silkscreen.gbo, arm-B_Silkscreen.gbr]
